CircuitCo/BeagleBone-Audio-RevA/BeagleBone-Audio-RevA-bom.xls

BeagleBone Audio Cape |  |  | 2012-08-14
Rev A
ITM | QTY | PART DESIGNATOR | PART | DESCRIPTIONS | MAN | PART # | COMMENTS
1 | 4 | C1,C2,C3,C4 | 10uF,10V | CAP CER 10UF 10V Y5V 0805 | TDK | C2012Y5V1A106Z
3 | 2 | C46,C47 | 47uF | CAP CER 47UF 10V X5R 1210 | Murata | GRM32ER61A476KE20L
4 | 4 | C48,C49,C53,C61 | 47pF | CAP CER 47PF 50V C0G 5% 0402 | TDK | C1005C0G1H470J
5 | 9 | C50,C51,C52,C54,C57,C60,C63,C78,C79 | 0.1uF | CAP 0.1uF 16V 10% 0402 X7R | Kemet | C0402C104K4RACT
6 | 5 | C55,C56,C58,C59,C62 | 10uF,0805 | CAP CER 10UF 10V Y5V 0805 | TDK | C2012Y5V1A106Z
8 | 4 | D1,D2,D3,D4 | PGB0010603MR | Ferrite Bead 150 Ohm 800mA | Steward | LI0805H151R-10
9 | 2 | D5,D6 | 598-8170-107F | LED Green SMD 20mA 2V 0805 | Dialight | 598-8170-107F
10 | 3 | FB6,FB7,FB8 | MMZ1608R301A | FERRITE CHIP 300 OHM 500MA 0603 | TDK | MMZ1608R301A
11 | 2 | P1,P2 | 2x23 HEADER FEMALE | .100 CL Dual Row- Straight Socket Strip- using .025" Sq. Pins | MLE | SSHQ-123-D-08-G-LF
 |  |  | 2x23 HEADER FEMALE | .100 CL Dual Row- Straight Socket Strip- using .025" Sq. Pins | MLE | SSHQ-123-D-08-F-LF
12 | 1 | P3 | 2x5 HEADER FEMALE | .100 CL Dual Row- Straight Socket Strip- using .025" Sq. Pins | MLE | SSHQ-105-D-08-G-LF
 |  |  | 2x5 HEADER FEMALE | .100 CL Dual Row- Straight Socket Strip- using .025" Sq. Pins | MLE | SSHQ-105-D-08-F-LF
13 | 2 | P6,P7 | PHONOJACK STEREO-R | CONN JACK STEREO 3POS 3.5MM SMD | CUI | SJ1-3513-SMT
14 | 1 | Q1 | DMC56404 | TRANS NPN/NPN W/RES 50V SMINI6 | Panasonic | DMC564040R
16 | 3 | R108,R109,R110 | 33402 | RES 33.0 OHM 1/16W 1% 0402 SMD | Yaego | RC0805FR-0749R9L
17 | 1 | R111 | .1,0805 | RES .10 OHM 1/8W 5% 0805 | CTS | 73L3R10J
18 | 1 | R112 | 28K | RES 28.0K OHM 1/16W 1% 0402 SMD | Yaego | RC0402FR-0728KL
19 | 1 | R113 | 56.2K | RES 56.2K OHM 1/16W 1% 0402 SMD | Yaego | CRCW040256K2FKED
20 | 2 | R114,R115 | 5.6K | RES 5.6K OHM 1/16W 5% 0402 SMD | Yaego | RC0402JR-075K6L
21 | 3 | R116,R117,R118 | 4.75K | RES 4.75K OHM 1/16W 1% 0402 SMD | Stackpole Electronics | RMCF0402FT4K75
22 | 2 | R119,R120 | 470,5% | RES 470 OHM 1/10W 5% 0402 SMD | Panasonic | ERJ-2GEJ471X
23 | 2 | R121,R122 | 100K,1% | Resistor 100Kohm 1/16W 1% 0402 | Yageo | CRCW0402100KJNED
24 | 1 | R123 | 10K | Resistor 10Kohm 1/16W 5% 0402 | Rohm | MCR01MZPJ103
25 | 2 | R130,R132 | 402 | Resistor Zero ohm Jumper 0402 | Yaego | RC0402JR-070RL
27 | 1 | SW1 | 2 POS Dip Switch | SWITCH TAPE SEAL 2 POS SMD | CTS | 219-2MST
29 | 1 | U6 | TLV320AIC3106 | IC STER AUD CODEC 32 BIT 48-VQFN | TI | TLV320AIC3106IRGZR
30 | 1 | U7 | TPS73701DRBR | IC REG LDO CAP FREE 8-SON | TI | TPS73701DRBR
31 | 1 | U8 | CAT24C256W | IC EEPROM 256KBIT 400KHZ 8SOIC | ON | CAT24C256WI-G
33 | 1 | Y1 | 12MHz | OSCILLATOR 12.000 MHZ 3.3V SMD | Fox | FXO-HC735-12
 | DNI | C5,C6,C67,C68,C69,C70,C71,C72,C73,C74,C75, C76,C77,C80,C81,R1,131,R133,U9
