CircuitCo/BeagleBone-Audio-RevA/(list of files, drawings)

Other design files:
BeagleBone-Audio-RevA-schematic.dsn
