CircuitCo/BeagleBone-Audio-RevA/(commit log)

2012-08-30 rm schematic
    [BeagleBone-Audio-RevA-schematic.dsn]
2012-08-30 upd schematic
    [BeagleBone-Audio-RevA-schematic.dsn]
